LongHairedHacker/HeptaLED/issues.md

Version 1.0
===========

Driver Board
------------
* Strange mount hole (plating) at RJ45 Connector
* Wrongly connected mosfets
* Add overvoltage/current protection to inputs and outputs

Level Shifter Board
-------------------
* Wrong footprint for fuses (pin distance)
* Use high side switch instead of fiddeling with mosfets
* Add overvoltage/current protection to inputs and outputs (MMSZ5234BT1G)
* Use 74hc74 as flipflop
