LongHairedHacker/HeptaLED/7segments.dxf

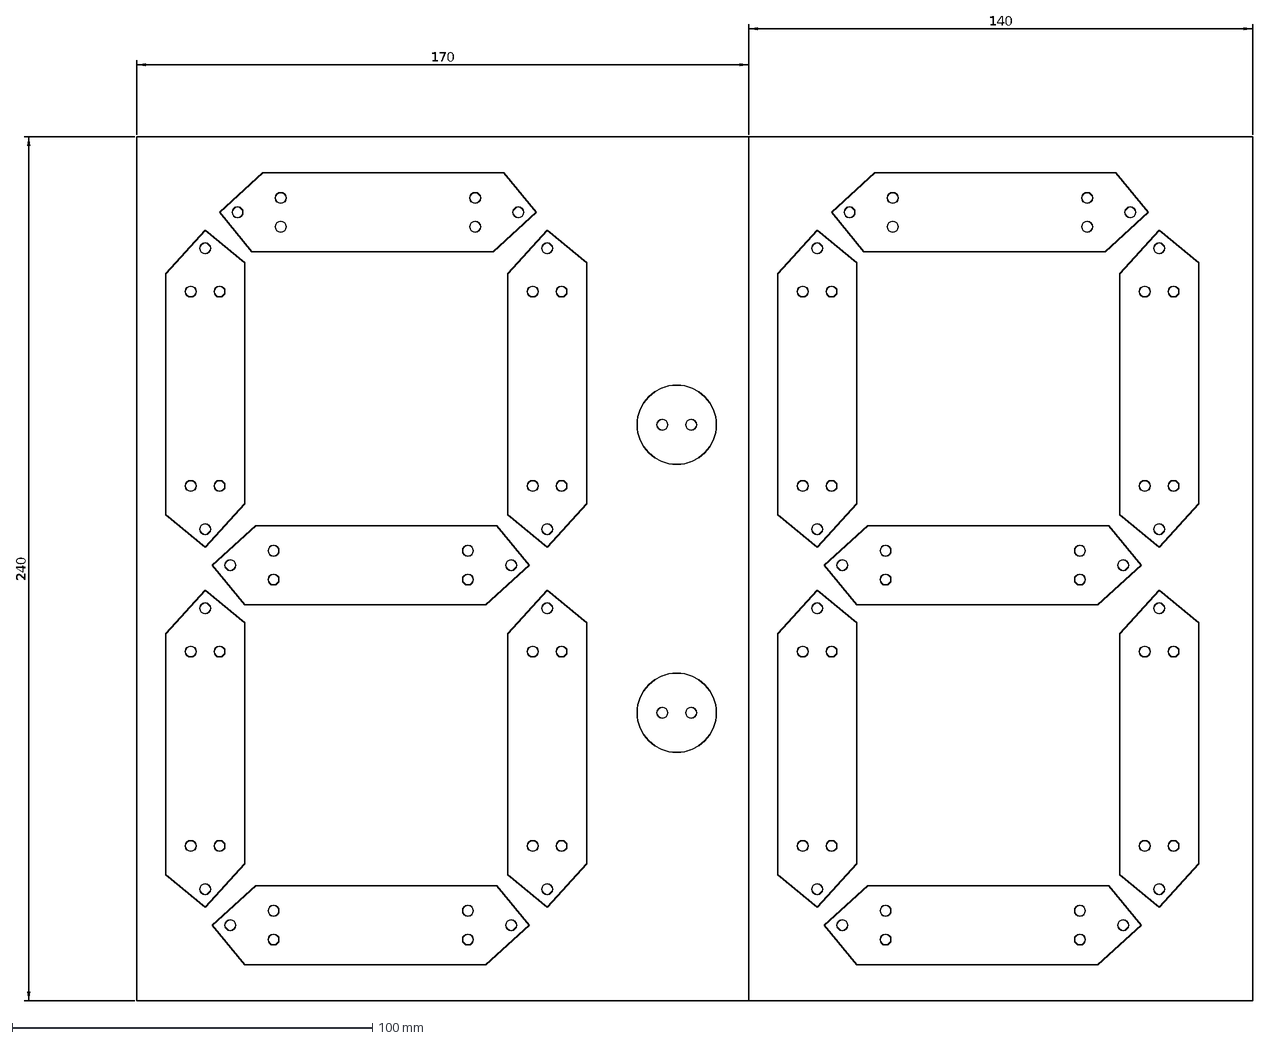
[picture p1: CAD file, 2014-08-23]
7segments.dxf
170
240
140
