LongHairedHacker/HeptaLED/case/rj45lid.stl

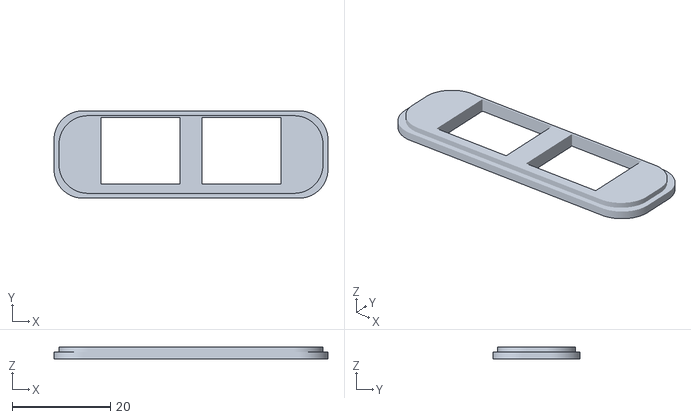
[picture p2: CAD file, 2014-03-23]
case/rj45lid.stl
55.8 x 17.8 x 2.50
