LongHairedHacker/HeptaLED/case/he10lid.stl

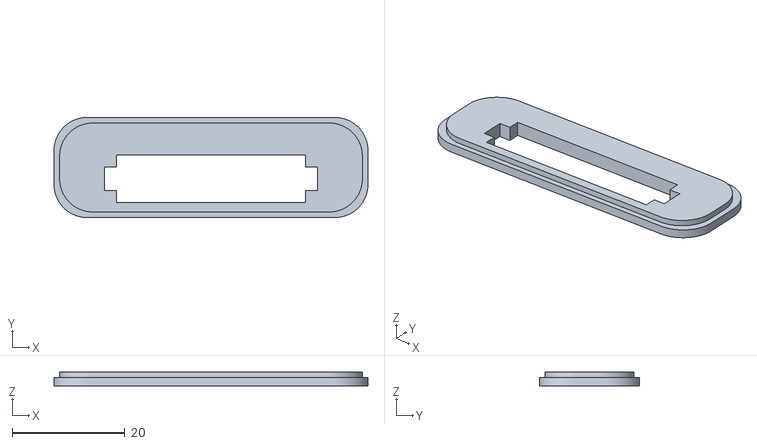
[picture p3: CAD file, 2014-03-23]
case/he10lid.stl
55.8 x 17.8 x 2.50
