LongHairedHacker/HeptaLED/segments.dxf

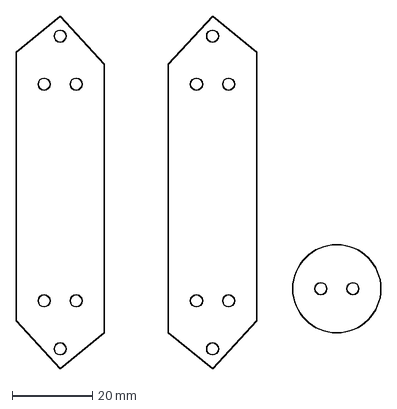
[picture p4: CAD file, 2014-07-31]
segments.dxf
91.0 x 88.0 mm
