LongHairedHacker/HeptaLED/(list of files, cad)

Other CAD files:
case/he10lid.dxf
case/rj45lid.dxf
