LongHairedHacker/HeptaLED/case/rj45lid.pdf

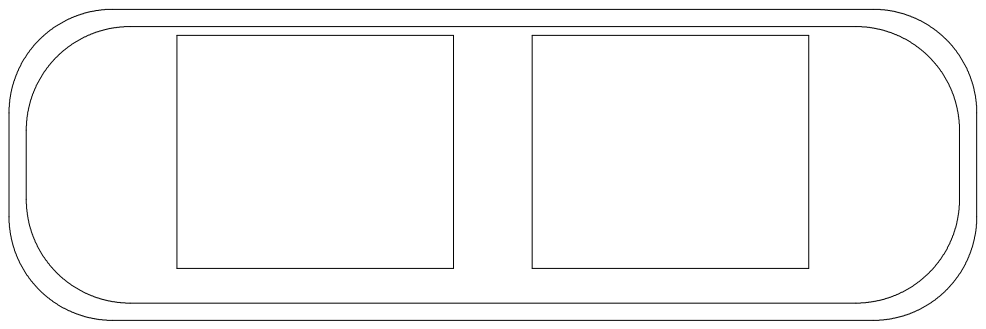
[picture p5: page 1]
