LongHairedHacker/HeptaLED/boards/levelshifter/leveshifterboard.kicad_pcb

## KiCad design boards/levelshifter/leveshifterboard.kicad_pcb (2014-11-21)

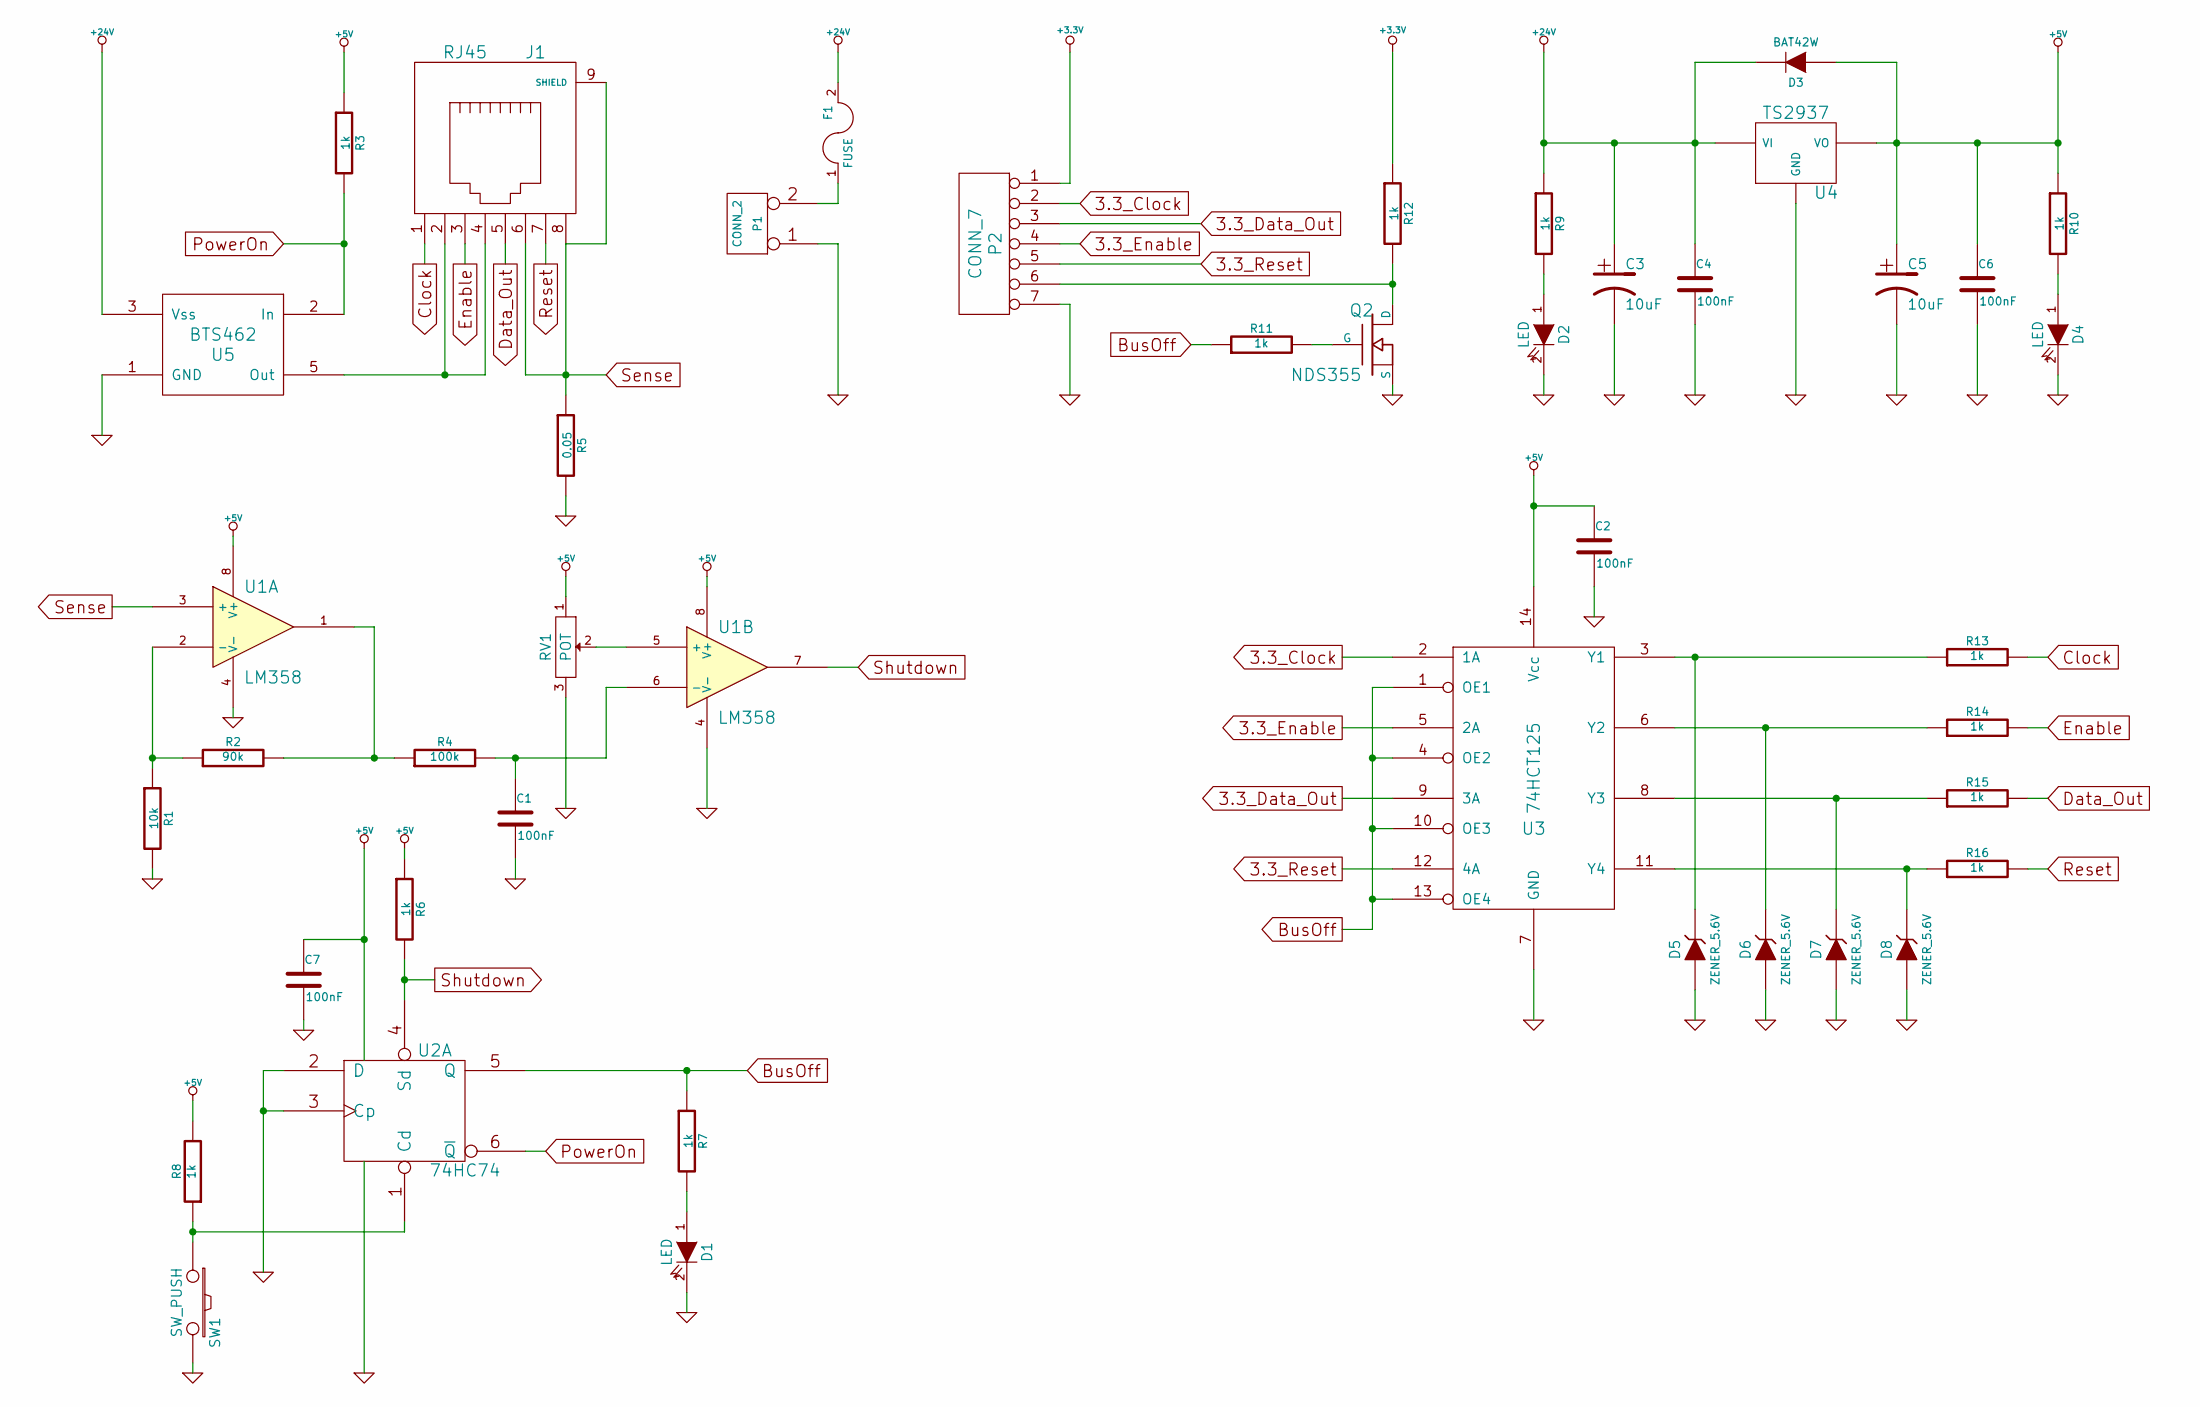
[picture p6: schematic leveshifterboard.sch, noname.sch]

Parts:
C1, C2, C4, C6, C7: 100nF
C3, C5: 10uF
D1, D2, D4: LED
D3: BAT42W
D5, D6, D7, D8: ZENER_5.6V
F1: FUSE
J1: RJ45
P1: CONN_2
P2: CONN_7
Q2: NDS355
R1: 10k
R2: 90k
R3, R6, R7, R8, R9, R10, R11, R12, R13, R14, R15, R16: 1k
R4: 100k
R5: 0.05
RV1: POT
SW1: SW_PUSH
U1: LM358
U2: 74HC74
U3: 74HCT125
U4: TS2937
U5: BTS462

Connections:
3.3_Clock: P2.2, U3.2 (1A)
3.3_Data_Out: P2.3, U3.9 (3A)
3.3_Enable: P2.4, U3.5 (2A)
3.3_Reset: P2.5, U3.12 (4A)
+3.3V: P2.1, R12.1
+5V: C2.1, C5.1, C6.1, C7.1, D3.1 (A), R3.1, R6.1, R8.2, R10.1, RV1.1, U1.8 (V+), U2.14 (VCC), U3.14 (Vcc), U4.3 (VO)
+24V: C3.1, C4.1, D3.2 (K), F1.2, R9.1, U4.1 (VI), U5.3 (Vss)
BusOff: R7.1, R11.1, U2.5 (Q), U3.1 (OE1), U3.4 (OE2), U3.10 (OE3), U3.13 (OE4)
Clock: J1.1, R13.2
Data_Out: J1.5, R15.2
Enable: J1.3, R14.2
GND: C1.2, C2.2, C3.2, C4.2, C5.2, C6.2, C7.2, D1.2 (K), D2.2 (K), D4.2 (K), D5.1 (A), D6.1 (A), D7.1 (A), D8.1 (A), P1.1, P2.7, Q2.3 (S), R1.2, R5.2, RV1.3, SW1.2, U1.4 (V-), U2.2 (D), U2.3 (Cp), U2.7 (GND), U3.7 (GND), U4.2 (GND), U5.1 (GND)
unnamed: C1.1, R4.2, U1.6 (-)
unnamed: P2.6, Q2.2 (D), R12.2
unnamed: D1.1 (A), R7.2
unnamed: R8.1, SW1.1, U2.1 (Cd)
unnamed: D8.2 (K), R16.1, U3.11 (Y4)
unnamed: D7.2 (K), R15.1, U3.8 (Y3)
unnamed: D6.2 (K), R14.1, U3.6 (Y2)
unnamed: D5.2 (K), R13.1, U3.3 (Y1)
unnamed: Q2.1 (G), R11.2
unnamed: RV1.2, U1.5 (+)
unnamed: R2.2, R4.1, U1.1
unnamed: F1.1, P1.2 (PM)
unnamed: D4.1 (A), R10.2
unnamed: J1.2, J1.4, U5.5 (Out)
unnamed: D2.1 (A), R9.2
unnamed: R1.1, R2.1, U1.2 (-)
PowerOn: R3.2, U2.6 (~Q), U5.2 (In)
Reset: J1.7, R16.2
Sense: J1.6, J1.8, J1.9 (SHIELD), R5.1, U1.3 (+)
Shutdown: R6.2, U1.7, U2.4 (Sd)

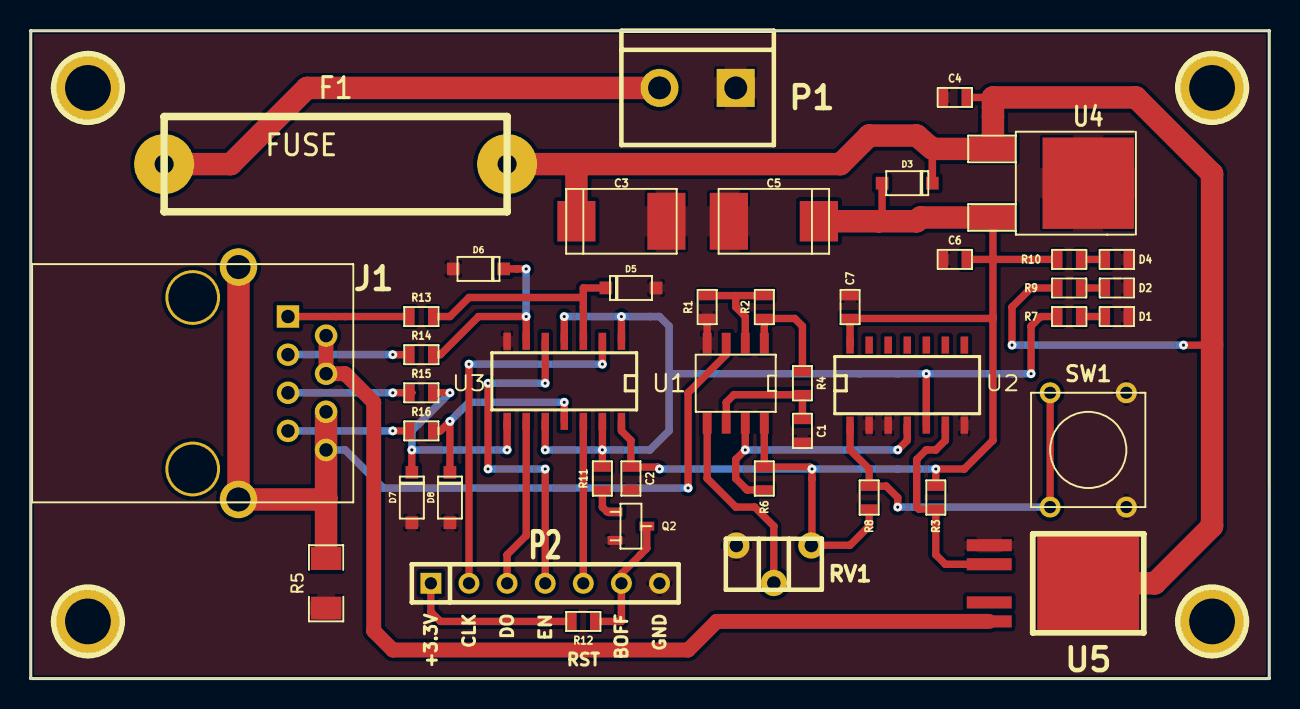
[picture p7: board leveshifterboard.kicad_pcb from above]

Board: 2 copper layers, 82.5 x 43.2 mm, 47 parts (0 on the bottom side), 32 nets.

Other parts of the board:
1PIN, 1PIN#2, 1PIN#3, 1PIN#4: P***; 1pin
