LongHairedHacker/HeptaLED/boards/driver/driverboard.kicad_pcb

## KiCad design boards/driver/driverboard.kicad_pcb (2014-10-22)

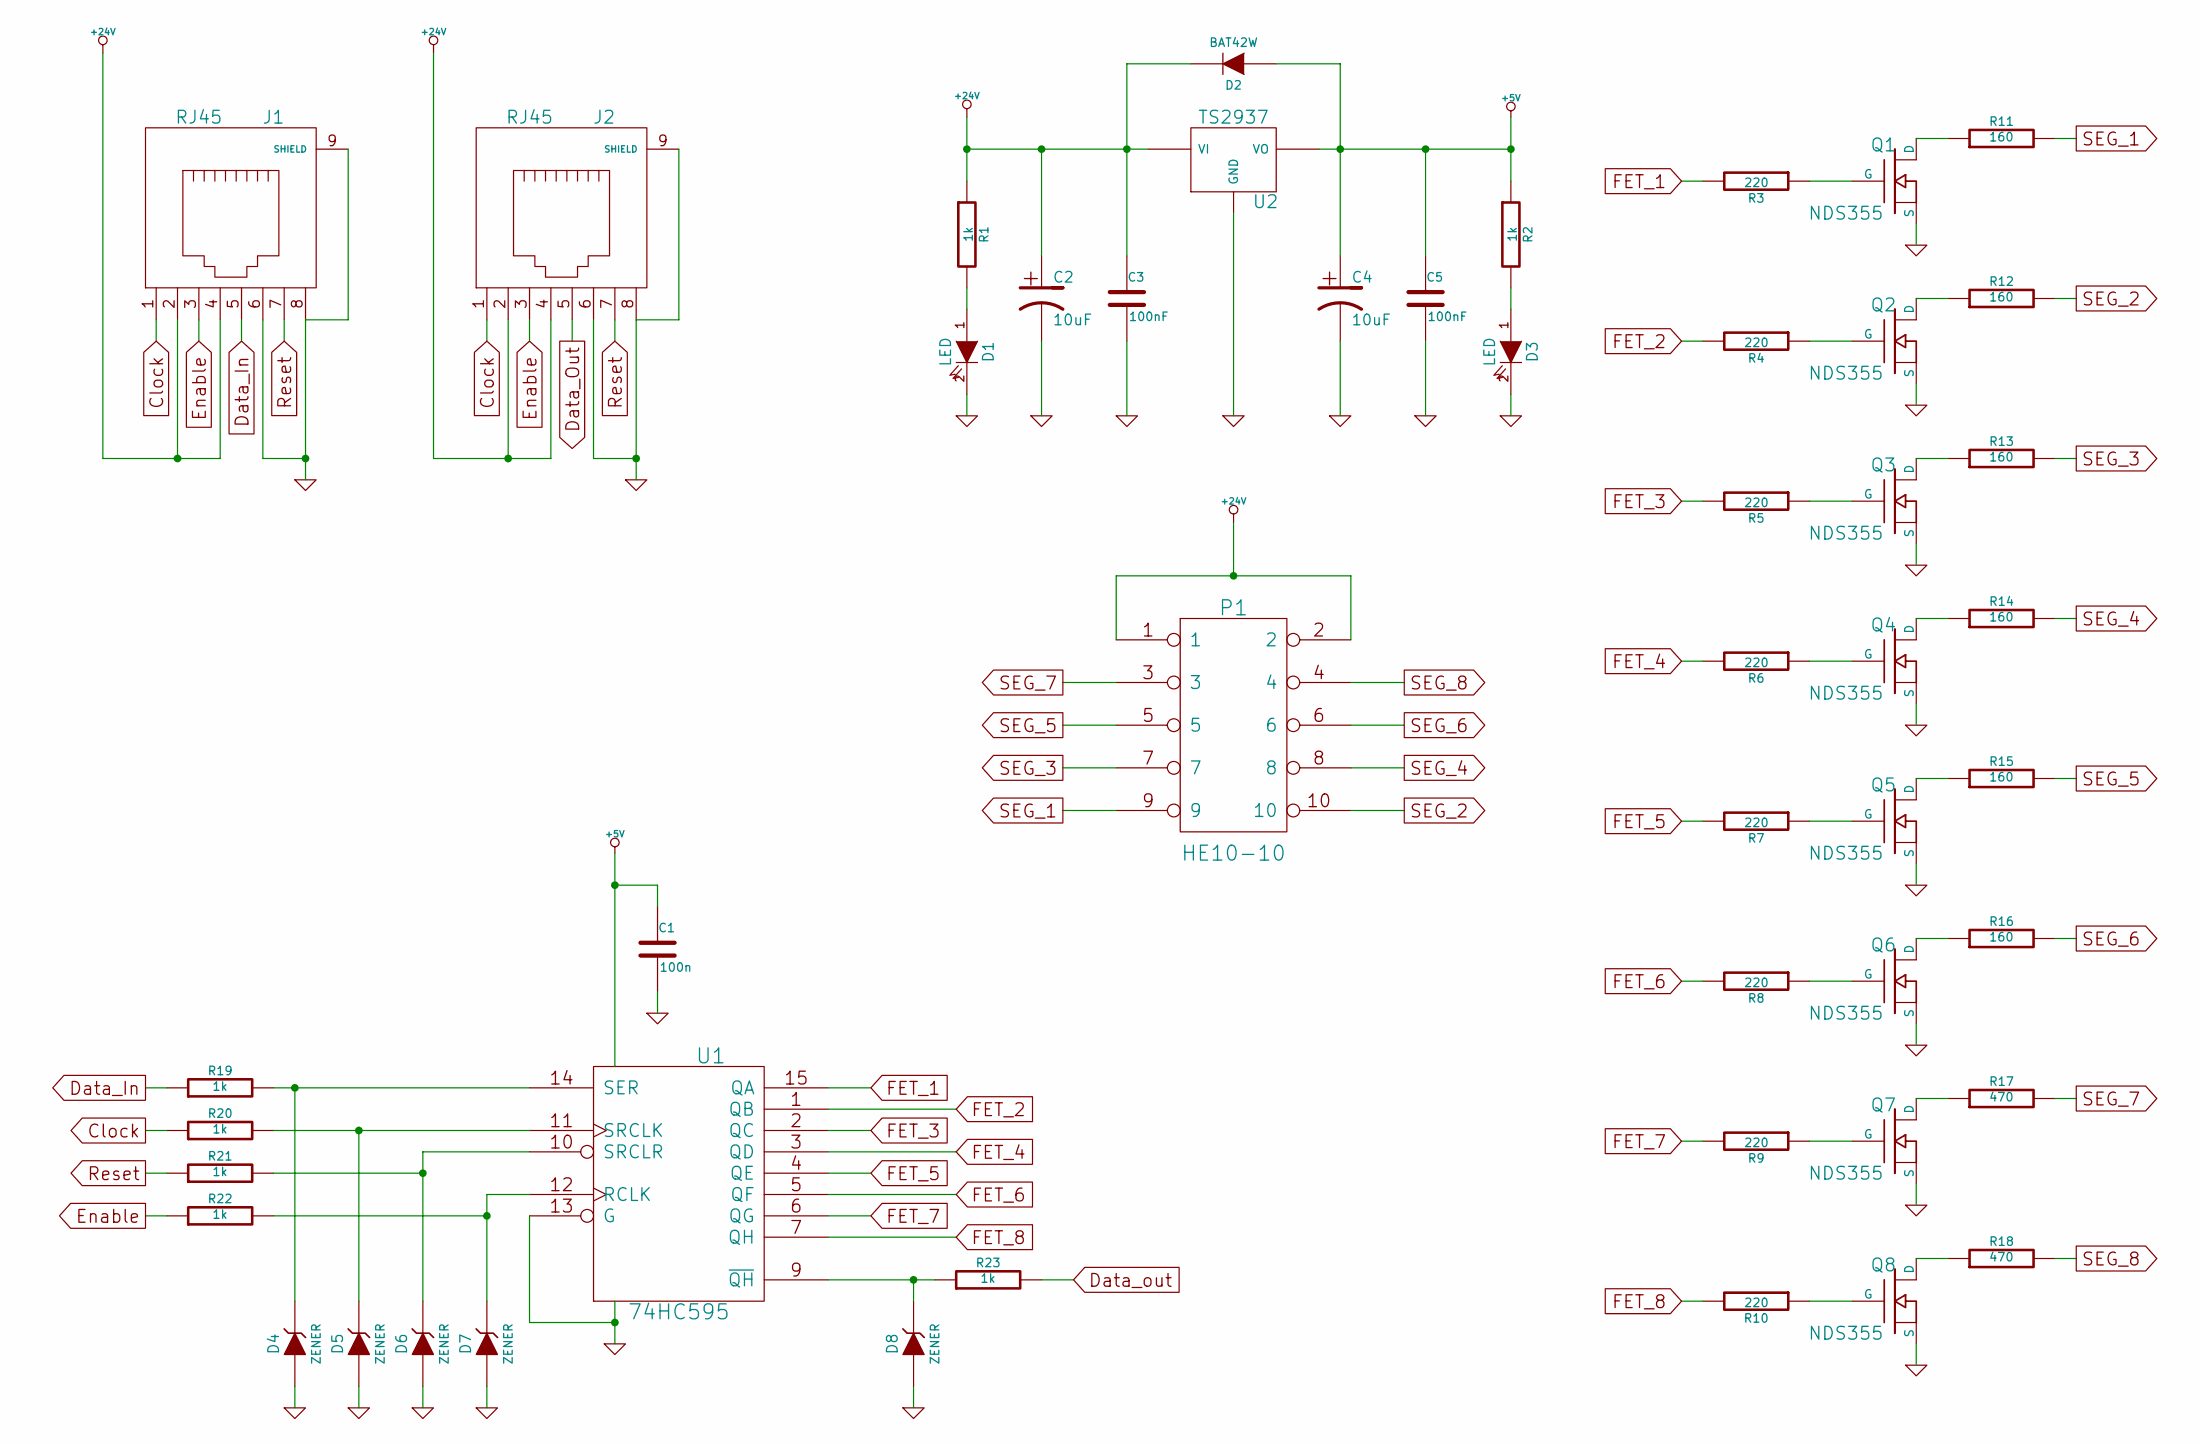
[picture p8: schematic driverboard.sch]

Parts:
C1: 100n
C2, C4: 10uF
C3, C5: 100nF
D1, D3: LED
D2: BAT42W
D4, D5, D6, D7, D8: ZENER
J1, J2: RJ45
P1: HE10-10
Q1, Q2, Q3, Q4, Q5, Q6, Q7, Q8: NDS355
R1, R2, R19, R20, R21, R22, R23: 1k
R3, R4, R5, R6, R7, R8, R9, R10: 220
R11, R12, R13, R14, R15, R16: 160
R17, R18: 470
U1: 74HC595
U2: TS2937

Connections:
+5V: C1.1, C4.1, C5.1, D2.1 (A), R2.1, U1.16 (VCC), U2.3 (VO)
+24V: C2.1, C3.1, D2.2 (K), J1.2, J1.4, J2.2, J2.4, P1.1, P1.2, R1.1, U2.1 (VI)
Clock: J1.1, J2.1, R20.1
Data_In: J1.5, R19.1
Data_Out: J2.5, R23.2
Enable: J1.3, J2.3, R22.1
FET_1: R3.2, U1.15 (QA)
FET_2: R4.2, U1.1 (QB)
FET_3: R5.2, U1.2 (QC)
FET_4: R6.2, U1.3 (QD)
FET_5: R7.2, U1.4 (QE)
FET_6: R8.2, U1.5 (QF)
FET_7: R9.2, U1.6 (QG)
FET_8: R10.2, U1.7 (QH)
GND: C1.2, C2.2, C3.2, C4.2, C5.2, D1.2 (K), D3.2 (K), D4.1 (A), D5.1 (A), D6.1 (A), D7.1 (A), D8.1 (A), J1.6, J1.8, J1.9 (SHIELD), J2.6, J2.8, J2.9 (SHIELD), Q1.3 (S), Q2.3 (S), Q3.3 (S), Q4.3 (S), Q5.3 (S), Q6.3 (S), Q7.3 (S), Q8.3 (S), U1.8 (GND), U1.13 (G), U2.2 (GND)
unnamed: Q4.2 (D), R14.1
unnamed: Q4.1 (G), R6.1
unnamed: Q3.2 (D), R13.1
unnamed: Q3.1 (G), R5.1
unnamed: Q2.1 (G), R4.1
unnamed: Q1.2 (D), R11.1
unnamed: Q1.1 (G), R3.1
unnamed: Q2.2 (D), R12.1
unnamed: Q5.2 (D), R15.1
unnamed: Q5.1 (G), R7.1
unnamed: Q6.2 (D), R16.1
unnamed: D6.2 (K), R21.2, U1.10 (SRCLR)
unnamed: D5.2 (K), R20.2, U1.11 (SRCLK)
unnamed: D8.2 (K), R23.1, U1.9 (~QH)
unnamed: D4.2 (K), R19.2, U1.14 (SER)
unnamed: D7.2 (K), R22.2, U1.12 (RCLK)
unnamed: Q8.2 (D), R18.1
unnamed: Q8.1 (G), R10.1
unnamed: Q7.2 (D), R17.1
unnamed: Q7.1 (G), R9.1
unnamed: Q6.1 (G), R8.1
unnamed: D3.1 (A), R2.2
unnamed: D1.1 (A), R1.2
Reset: J1.7, J2.7, R21.1
SEG_1: P1.9, R11.2
SEG_2: P1.10, R12.2
SEG_3: P1.7, R13.2
SEG_4: P1.8, R14.2
SEG_5: P1.5, R15.2
SEG_6: P1.6, R16.2
SEG_7: P1.3, R17.2
SEG_8: P1.4, R18.2

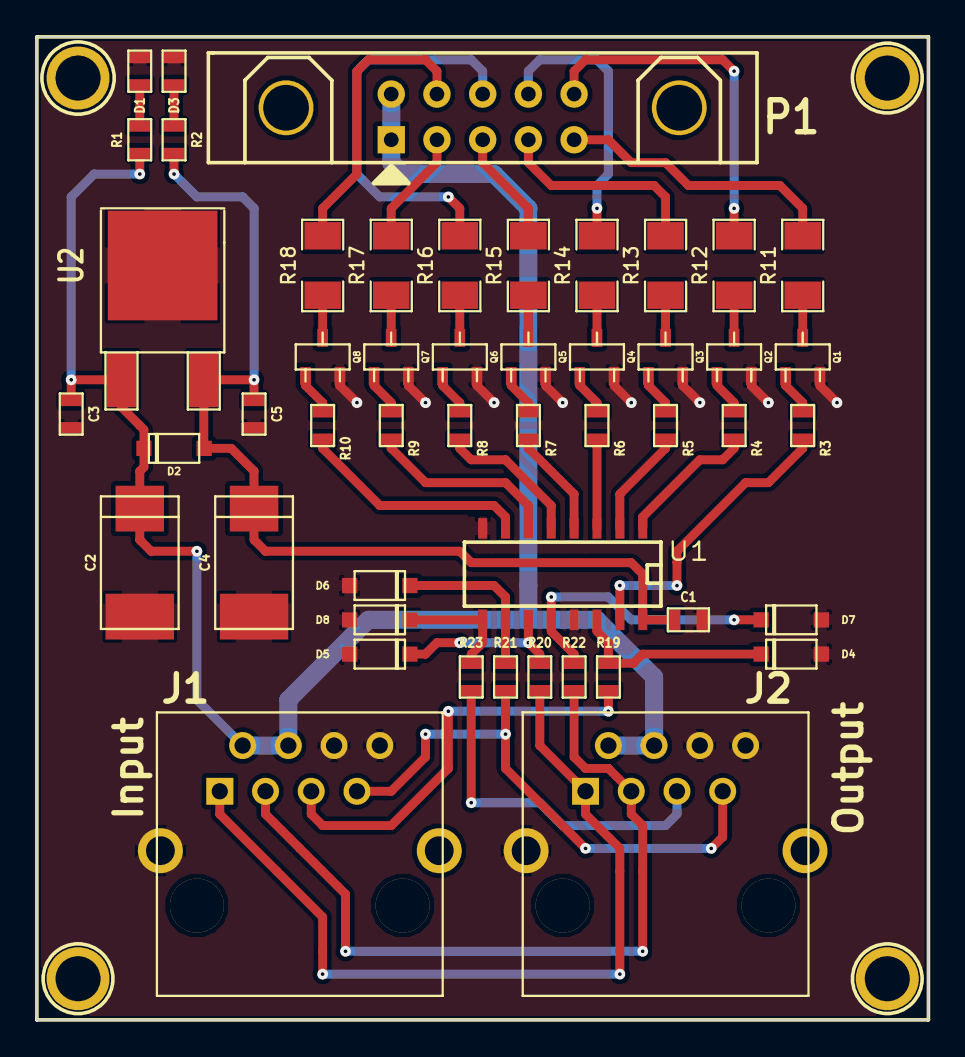
[picture p9: board driverboard.kicad_pcb from above]

Board: 2 copper layers, 49.5 x 54.6 mm, 53 parts (0 on the bottom side), 47 nets.

Other parts of the board:
1PIN, 1PIN#2, 1PIN#3, 1PIN#4: P***; 1pin
