LongHairedHacker/HeptaLED/(commit log)

2014-01-28 First version of board
2014-01-29 Cleaned up silkscreen
    [driverboard.kicad_pcb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]
2014-02-16 Added holes to driver board
    [driverboard.kicad_pcb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]
2014-02-16 Added cad for enclosures
    [driverboard.kicad_pcb, he10lid.dxf, he10lid.stl, lid.scad, rj45lid.dxf, rj45lid.stl]
2014-02-17 Better folder structure
    [driverboard.kicad_pcb, driverboard.sch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]
2014-02-26 First levelshifter schematic
    [leveshifterboard.sch]
2014-02-26 Swicthed to integrated level shifter
    [leveshifterboard.sch]
2014-03-16 First version of levelshifter board
    [driverboard.kicad_pcb, leveshifterboard.kicad_pcb, leveshifterboard.sch, panelized.kicad_pcb]
2014-03-23 Semifinal version of enclosure lids
    [he10lid.dxf, he10lid.stl, leveshifterboard.kicad_pcb, rj45lid.dxf, rj45lid.stl]
2014-05-01 Small update on driverboard
    [driverboard.kicad_pcb, driverboard.sch]
2014-05-01 Fixed silkscreen
    [driverboard.kicad_pcb, leveshifterboard.kicad_pcb]
2014-05-01 Final version 1.0
    [driverboard.kicad_pcb, driverboard_panel.kicad_pcb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]
2014-05-01 Generate files for fabrication
    [driverboard.kicad_pcb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]
2014-05-24 Added devicetree overlay
2014-07-31 Added drawings for display
    [7segments.dxf, segments.dxf]
2014-08-17 Started fixing schematics
    [driverboard.sch]
2014-08-19 Updated driverboard layout
    [driverboard.kicad_pcb]
2014-08-23 Updated levelshifter schematic
    [7segments.dxf, leveshifterboard.sch]
2014-09-04 More work on levelshifter
    [leveshifterboard.sch]
2014-09-18 Fixed levelshifter board
    [leveshifterboard.kicad_pcb]
2014-09-18 Minor Silkscreen fixes
    [driverboard.kicad_pcb, leveshifterboard.kicad_pcb]
2014-10-21 Final fixes to board layouts
    [driverboard.kicad_pcb, leveshifterboard.kicad_pcb]
2014-10-21 Updated gerbers and postscripts
    [driverboard-B_Cu.gbl, driverboard-B_Mask.gbs, driverboard-B_Paste.gbp, driverboard-B_SilkS.gbo, driverboard-Edge_Cuts.gbr, driverboard-F_Cu.gtl, driverboard-F_Mask.gts, driverboard-F_SilkS.gto]
2014-10-21 Updated version number
    [leveshifterboard-B_Cu.gbl, leveshifterboard-B_Mask.gbs, leveshifterboard-B_Paste.gbp, leveshifterboard-B_SilkS.gbo, leveshifterboard-Edge_Cuts.gbr, leveshifterboard-F_Cu.gtl, leveshifterboard-F_Mask.gts, leveshifterboard-F_Paste.gtp]
2014-10-21 Panelized boards
    [driverboard_panel.kicad_pcb, leveshifterboard_panel.kicad_pcb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]
2014-10-22 Added logos
    [driverboard.kicad_pcb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]
2014-10-22 Fixed production files
    [panelized.kicad_pcb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]
2014-11-21 Updated resistor values
    [driverboard.sch, leveshifterboard.kicad_pcb]
